ericcheng94/arduino-traction-control/Demos/TC-motor-full-throttle.ino

#define enA 2
#define in1 22
#define in2 23
#define in3 24
#define in4 25
#define enB 3

void setup() {
  Serial.begin(9600);
  pinMode(enA, OUTPUT);
  pinMode(enB, OUTPUT);
  pinMode(in1, OUTPUT);
  pinMode(in2, OUTPUT);
  pinMode(in3, OUTPUT);
  pinMode(in4, OUTPUT);
}

void runFullThrottle()
{
   Serial.println("runningFullThrottle()");
  // turn on motor A
  digitalWrite(in1, HIGH);
  digitalWrite(in2, LOW);
  // set speed to 200 out of possible range 0~255
  analogWrite(enA, 200);
  // turn on motor B
  digitalWrite(in3, HIGH);
  digitalWrite(in4, LOW);
  // set speed to 200 out of possible range 0~255
  analogWrite(enB, 200);

}

void loop() {
  runFullThrottle();
  delay(1000);
}
