ericcheng94/arduino-traction-control/(commit log)

2019-02-25 added demo files for exploring LCD use and motor control
2019-02-26 added wheel speed sensor functionality and lcd wheel step and rpm display
2019-02-26 added logic to check multiple wheel speeds non working
2019-02-26 fixed logic with boolean flags to read two wheel speeds concurrently and print out its rpm
    [arduino_traction_control.ino]
2019-02-26 added all 4 wheels of speed measurement to code logic and displays front and rear speed on lcd
2019-02-26 added ultrasonic sensor support to stop vehicle motors when within 50cm, fleshed out traction control code
2019-02-26 added interrupt ability for traction control system and led TC indicator
2019-03-06 implemented external interrupts on wheel speed sensors, added copy of old code, updated README
2019-03-06 fixed attach interrupt not working by fixing typos, setting up attachinterrupt in setup(), and switching pins to pins that support external interrupts
    [arduino_traction_control.ino]
2019-05-14 imported libraries for MCP2515 and setup basic transmit and receive code for communication between two arduino boards
2019-05-14 adding crash detection ultrasonic code to can bus
    [arduino_traction_control.ino, arduino_transmit_spi_to_can_bus.ino]
2019-05-15 further fleshing out of can spi
